timChase98/SpeedOfLightContoller/hw/SpeedOfLightController.png

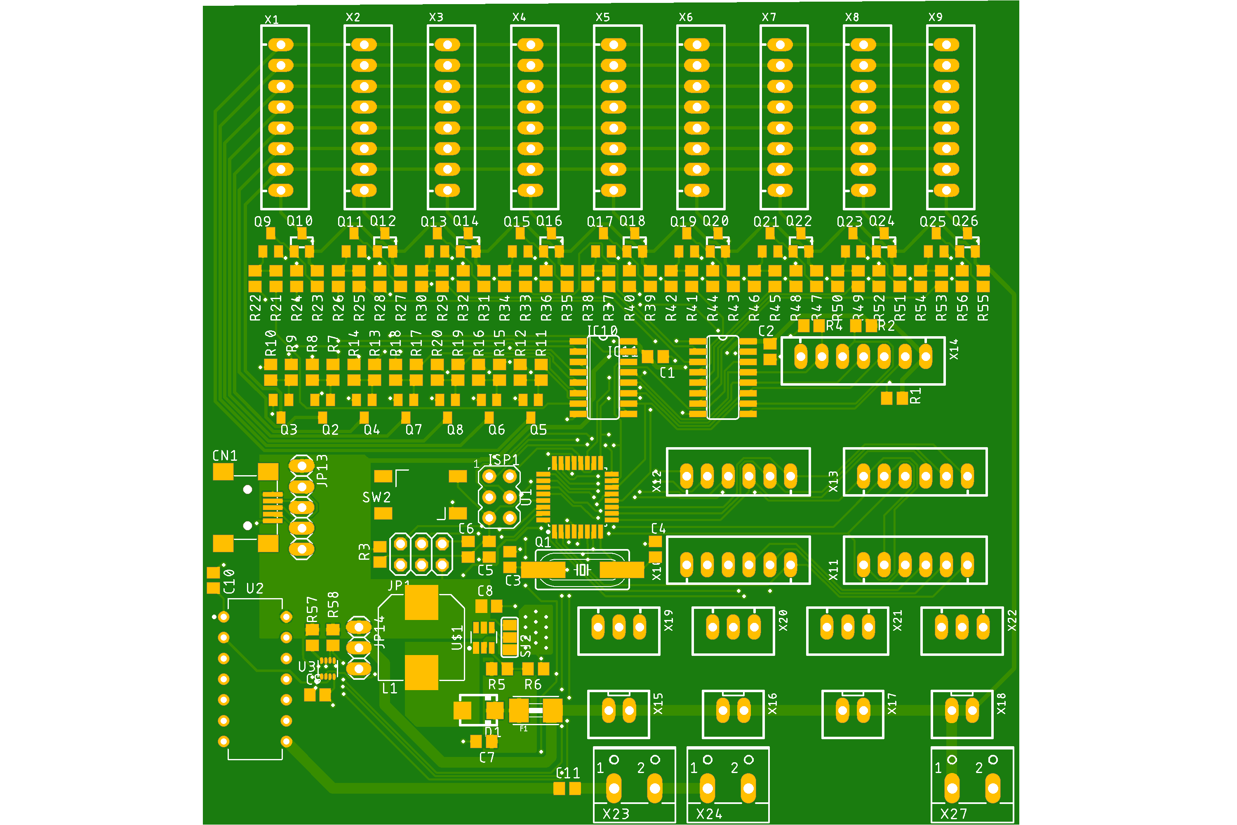
hw/SpeedOfLightController.png
