timChase98/SpeedOfLightContoller/hw/SpeedOfLightController.pdf

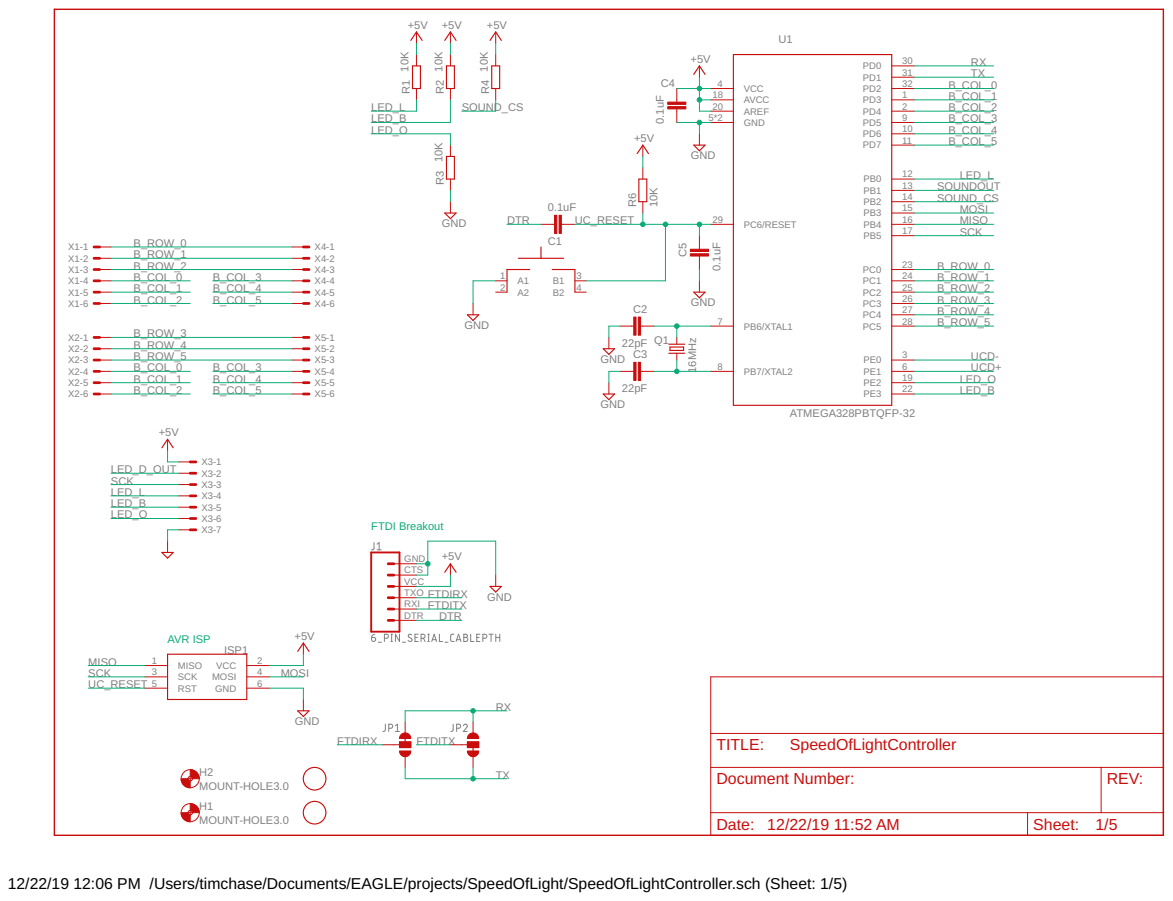
[picture p2: page 1]

Document Number: | REV:

Date: 12/22/19 11:52 AM | Sheet: 1/5

12/22/19 12:06 PM /Users/timchase/Documents/EAGLE/projects/SpeedOfLight/SpeedOfLightController.sch (Sheet: 1/5)

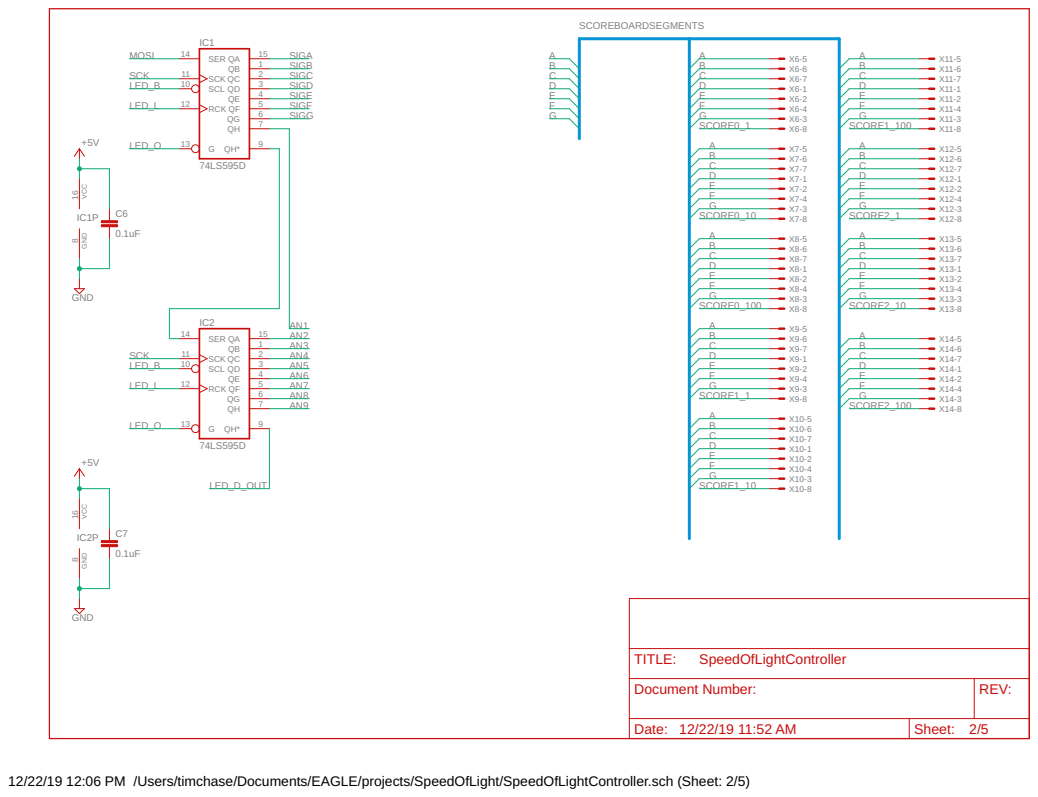
[picture p3: page 2]

Document Number: | REV:

Date: 12/22/19 11:52 AM | Sheet: 2/5

12/22/19 12:06 PM /Users/timchase/Documents/EAGLE/projects/SpeedOfLight/SpeedOfLightController.sch (Sheet: 2/5)

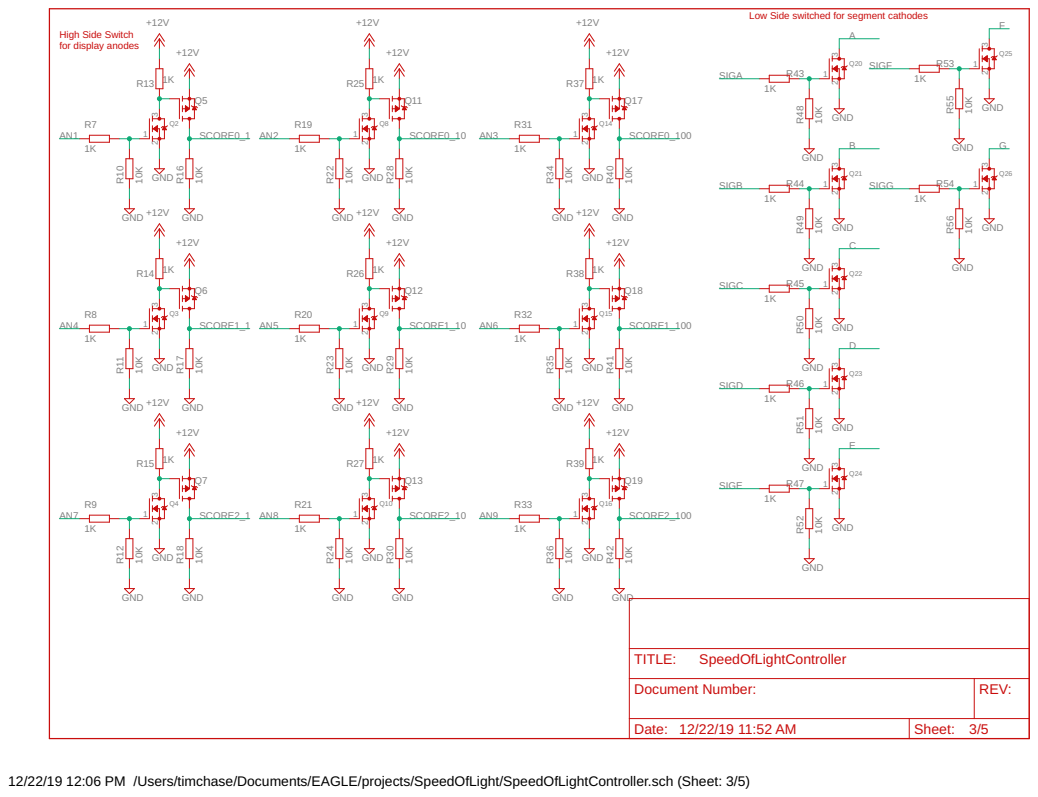
[picture p4: page 3]

Document Number: | REV:

Date: 12/22/19 11:52 AM | Sheet: 3/5

12/22/19 12:06 PM /Users/timchase/Documents/EAGLE/projects/SpeedOfLight/SpeedOfLightController.sch (Sheet: 3/5)

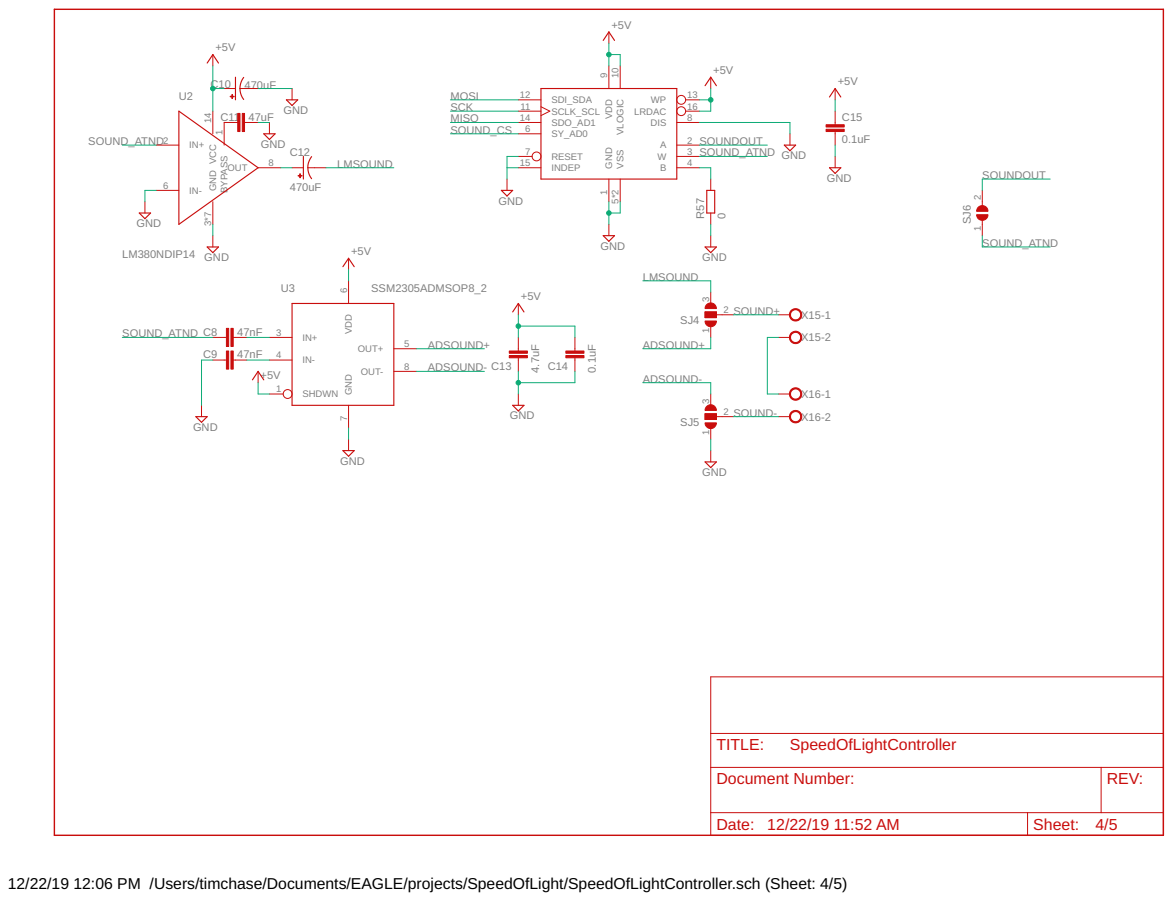
[picture p5: page 4]

Document Number: | REV:

Date: 12/22/19 11:52 AM | Sheet: 4/5

12/22/19 12:06 PM /Users/timchase/Documents/EAGLE/projects/SpeedOfLight/SpeedOfLightController.sch (Sheet: 4/5)

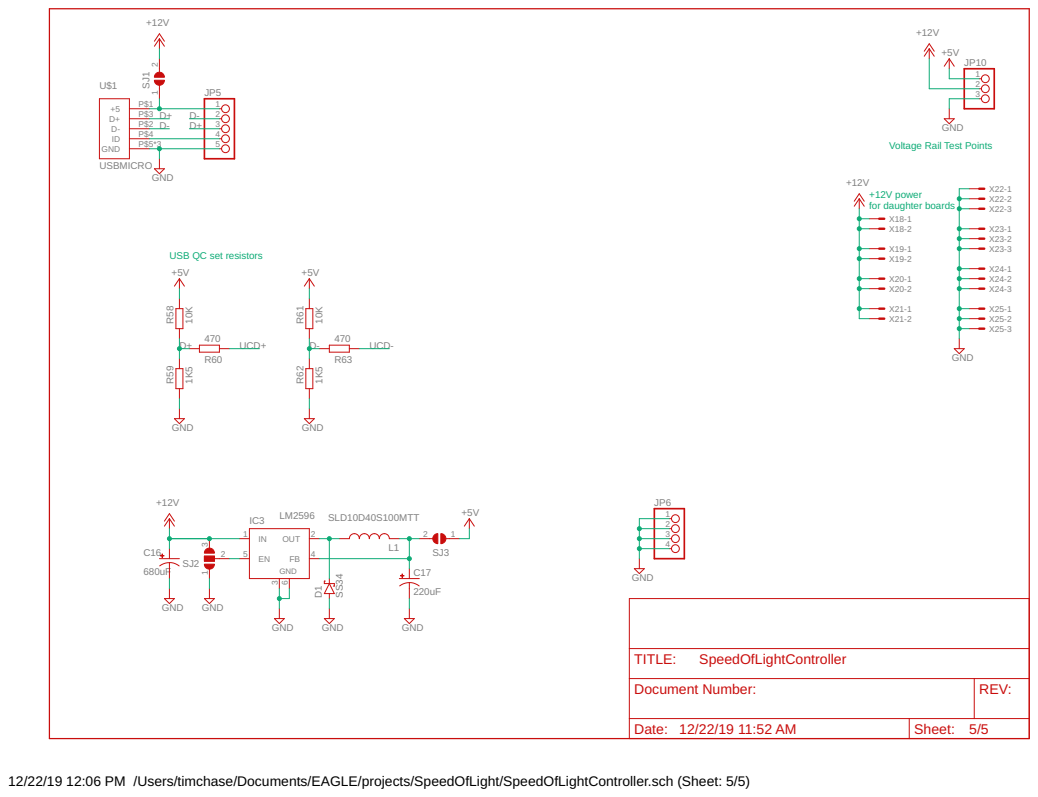
[picture p6: page 5]

Voltage Rail Test Points +12V power

for daughter boards USB QC set resistors

Document Number: | REV:

Date: 12/22/19 11:52 AM | Sheet: 5/5

12/22/19 12:06 PM /Users/timchase/Documents/EAGLE/projects/SpeedOfLight/SpeedOfLightController.sch (Sheet: 5/5)
