timChase98/SpeedOfLightContoller/hw/ButtonBreakout.pdf

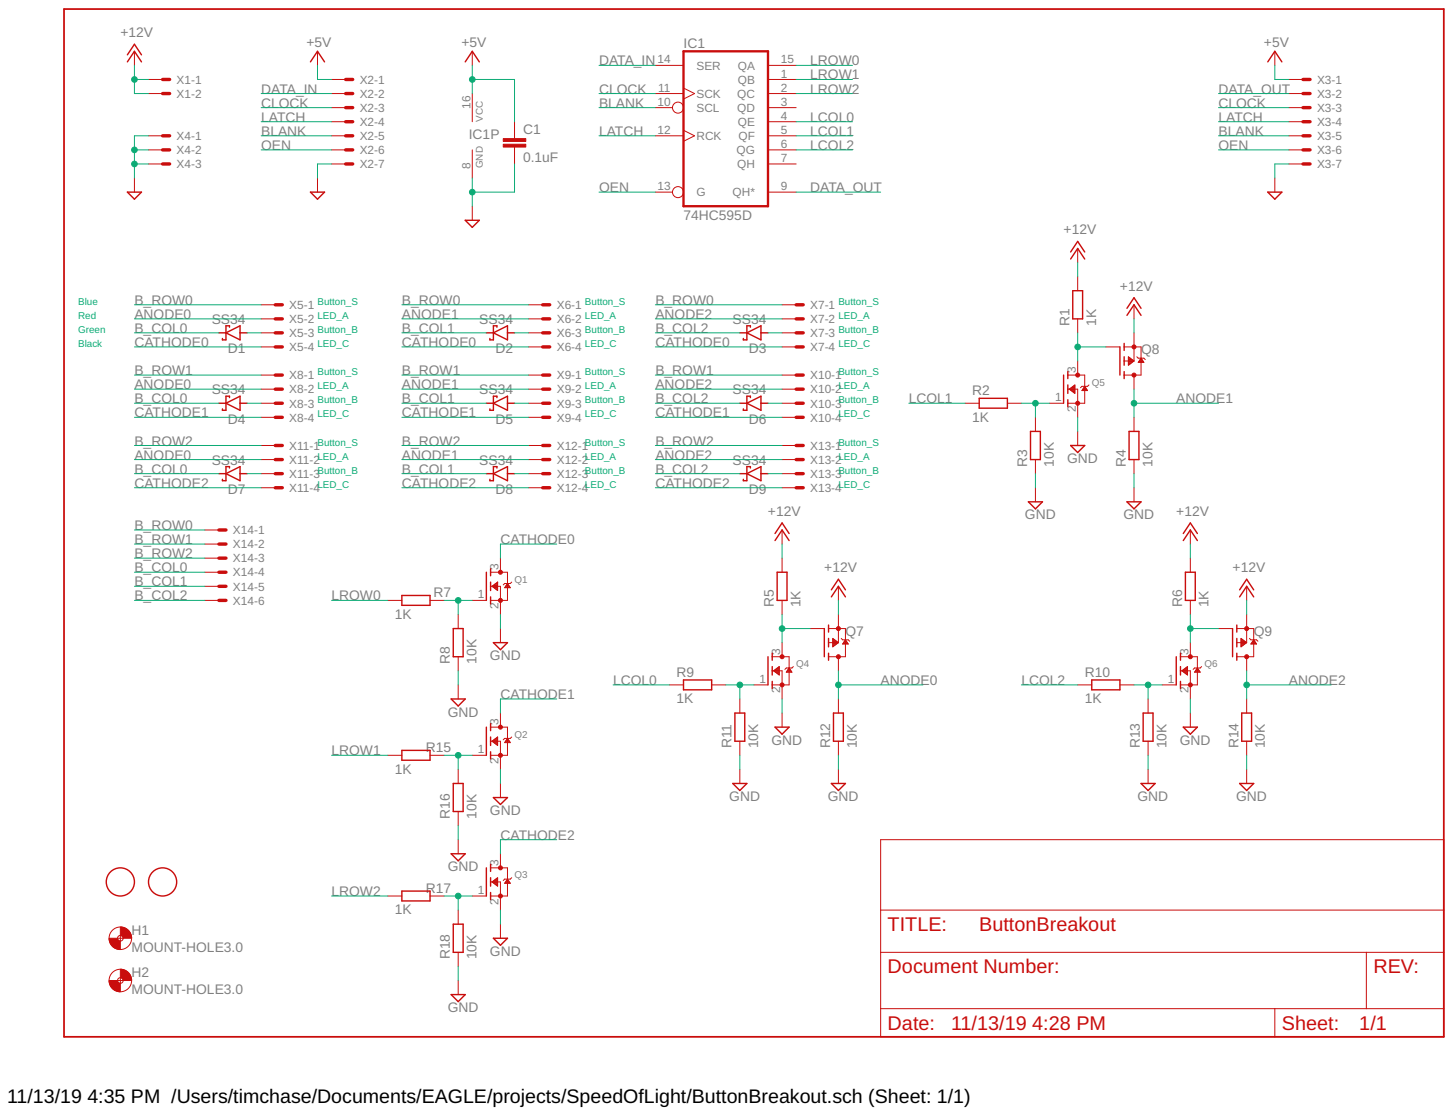
[picture p7: page 1]

Button_B Red Black Blue Green

Document Number: | REV:

Date: 11/13/19 4:28 PM | Sheet: 1/1

11/13/19 4:35 PM /Users/timchase/Documents/EAGLE/projects/SpeedOfLight/ButtonBreakout.sch (Sheet: 1/1)
