timChase98/SpeedOfLightContoller/ButtonBreakout.brd

## EAGLE design hw/ButtonBreakout.brd (2019-11-13, last stored version)

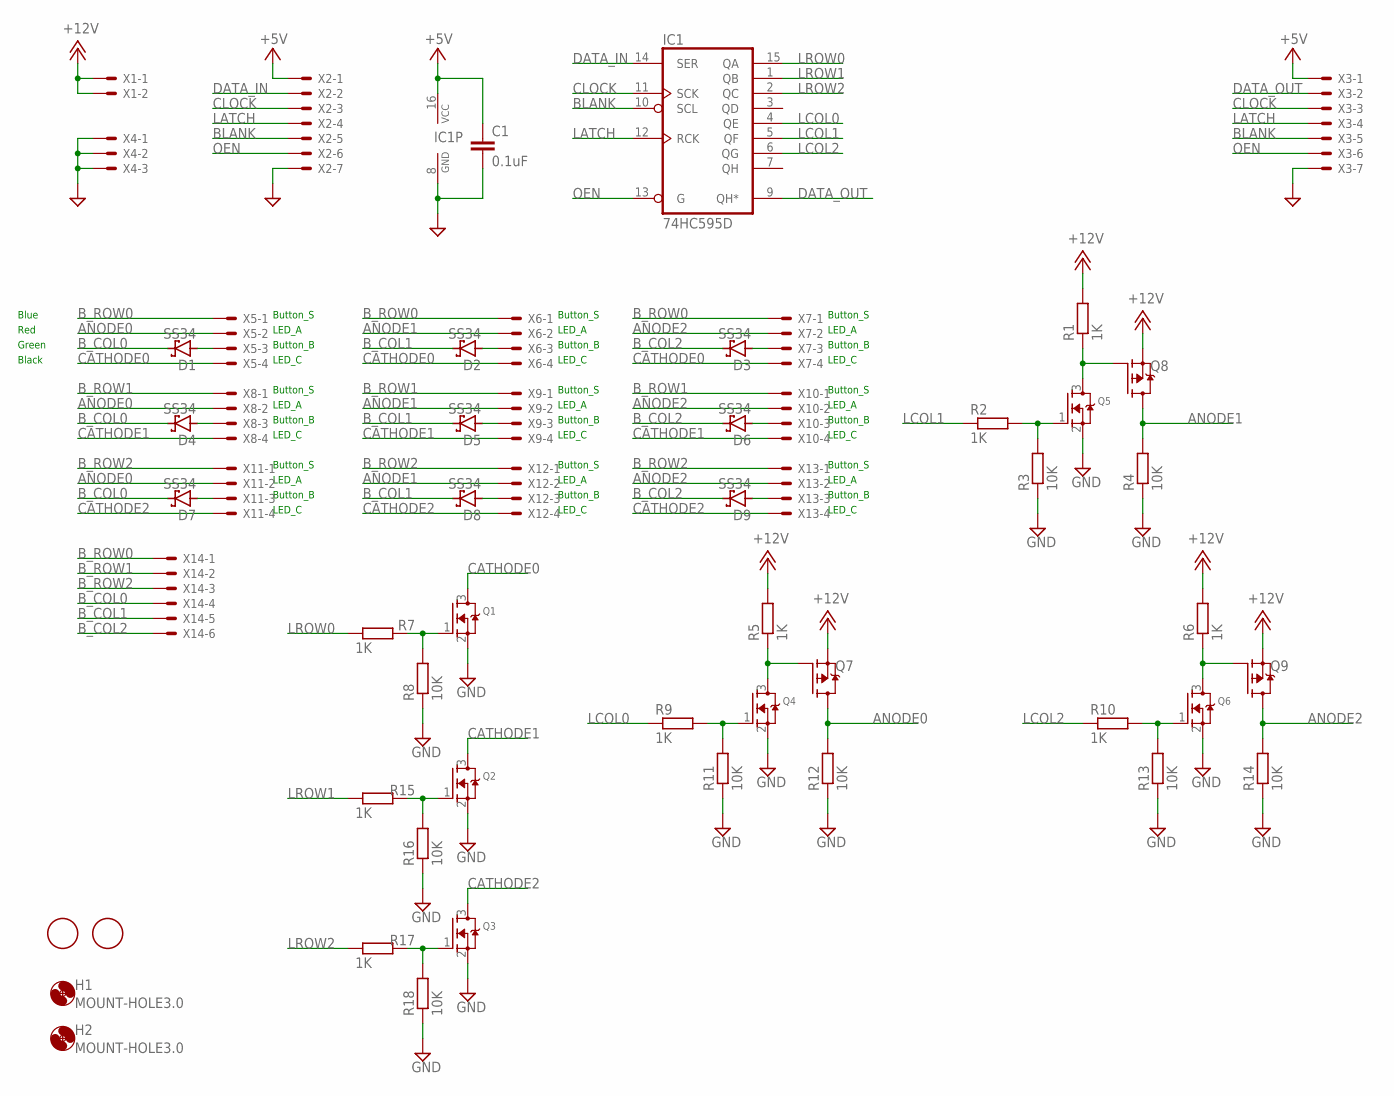
[picture p8: schematic ButtonBreakout.sch]

Parts:
C1: 0.1uF; C0805
D1, D2, D3, D4, D5, D6, D7, D8, D9: SS34; SMA
F1, F2: FIDUCIAL; FIDUCIAL_1MM
H1, H2: MOUNT-HOLE3.0; 3,0
IC1: 74HC595D; SO16
Q1, Q2, Q3, Q4, Q5, Q6: AO3414SOT23; SOT95P240X110-3N
Q7, Q8, Q9: AO3415; SOT95P240X110-3N
R1, R2, R5, R6, R7, R9, R10, R15, R17: 1K; R0805
R3, R4, R8, R11, R12, R13, R14, R16, R18: 10K; R0805
X1: JST-XH-02-PIN-LONG-PAD; JST-XH-02-PACKAGE-LONG-PAD
X2, X3: JST-XH-07-PIN-LONG-PAD; JST-XH-07-PACKAGE-LONG-PAD
X4: JST-XH-03-PIN-LONG-PAD; JST-XH-03-PACKAGE-LONG-PAD
X5, X6, X7, X8, X9, X10, X11, X12, X13: JST-XH-04-PIN-LONG-PAD; JST-XH-04-PACKAGE-LONG-PAD
X14: JST-XH-06-PIN-LONG-PAD; JST-XH-06-PACKAGE-LONG-PAD

Connections:
+5V: C1.1, IC1.16 (VCC), X2.1, X3.1
+12V: Q7.2 (S), Q8.2 (S), Q9.2 (S), R1.2, R5.2, R6.2, X1.1, X1.2
ANODE0: Q7.3 (D), R12.2, X5.2, X8.2, X11.2
ANODE1: Q8.3 (D), R4.2, X6.2, X9.2, X12.2
ANODE2: Q9.3 (D), R14.2, X7.2, X10.2, X13.2
BLANK: IC1.10 (SCL), X2.5, X3.5
B_COL0: D1.C, D4.C, D7.C, X14.4
B_COL1: D2.C, D5.C, D8.C, X14.5
B_COL2: D3.C, D6.C, D9.C, X14.6
B_ROW0: X5.1, X6.1, X7.1, X14.1
B_ROW1: X8.1, X9.1, X10.1, X14.2
B_ROW2: X11.1, X12.1, X13.1, X14.3
CATHODE0: Q1.3 (D), X5.4, X6.4, X7.4
CATHODE1: Q2.3 (D), X8.4, X9.4, X10.4
CATHODE2: Q3.3 (D), X11.4, X12.4, X13.4
CLOCK: IC1.11 (SCK), X2.3, X3.3
DATA_IN: IC1.14 (SER), X2.2
DATA_OUT: IC1.9 (QH*), X3.2
GND: C1.2, IC1.8 (GND), Q1.2 (S), Q2.2 (S), Q3.2 (S), Q4.2 (S), Q5.2 (S), Q6.2 (S), R3.1, R4.1, R8.1, R11.1, R12.1, R13.1, R14.1, R16.1, R18.1, X2.7, X3.7, X4.1, X4.2, X4.3
LATCH: IC1.12 (RCK), X2.4, X3.4
LCOL0: IC1.4 (QE), R9.1
LCOL1: IC1.5 (QF), R2.1
LCOL2: IC1.6 (QG), R10.1
LROW0: IC1.15 (QA), R7.1
LROW1: IC1.1 (QB), R15.1
LROW2: IC1.2 (QC), R17.1
unnamed: Q2.1 (G), R15.2, R16.2
unnamed: Q3.1 (G), R17.2, R18.2
unnamed: Q5.3 (D), Q8.1 (G), R1.1
unnamed: Q5.1 (G), R2.2, R3.2
unnamed: Q1.1 (G), R7.2, R8.2
unnamed: Q4.3 (D), Q7.1 (G), R5.1
unnamed: D1.A, X5.3
unnamed: D2.A, X6.3
unnamed: D3.A, X7.3
unnamed: D4.A, X8.3
unnamed: D5.A, X9.3
unnamed: D6.A, X10.3
unnamed: D7.A, X11.3
unnamed: D8.A, X12.3
unnamed: D9.A, X13.3
unnamed: Q4.1 (G), R9.2, R11.2
unnamed: Q6.3 (D), Q9.1 (G), R6.1
unnamed: Q6.1 (G), R10.2, R13.2
OEN: IC1.13 (G), X2.6, X3.6

Notes on the sheet:
LED_A
LED_C
Button_S
Button_B
Red
Black
Blue
Green

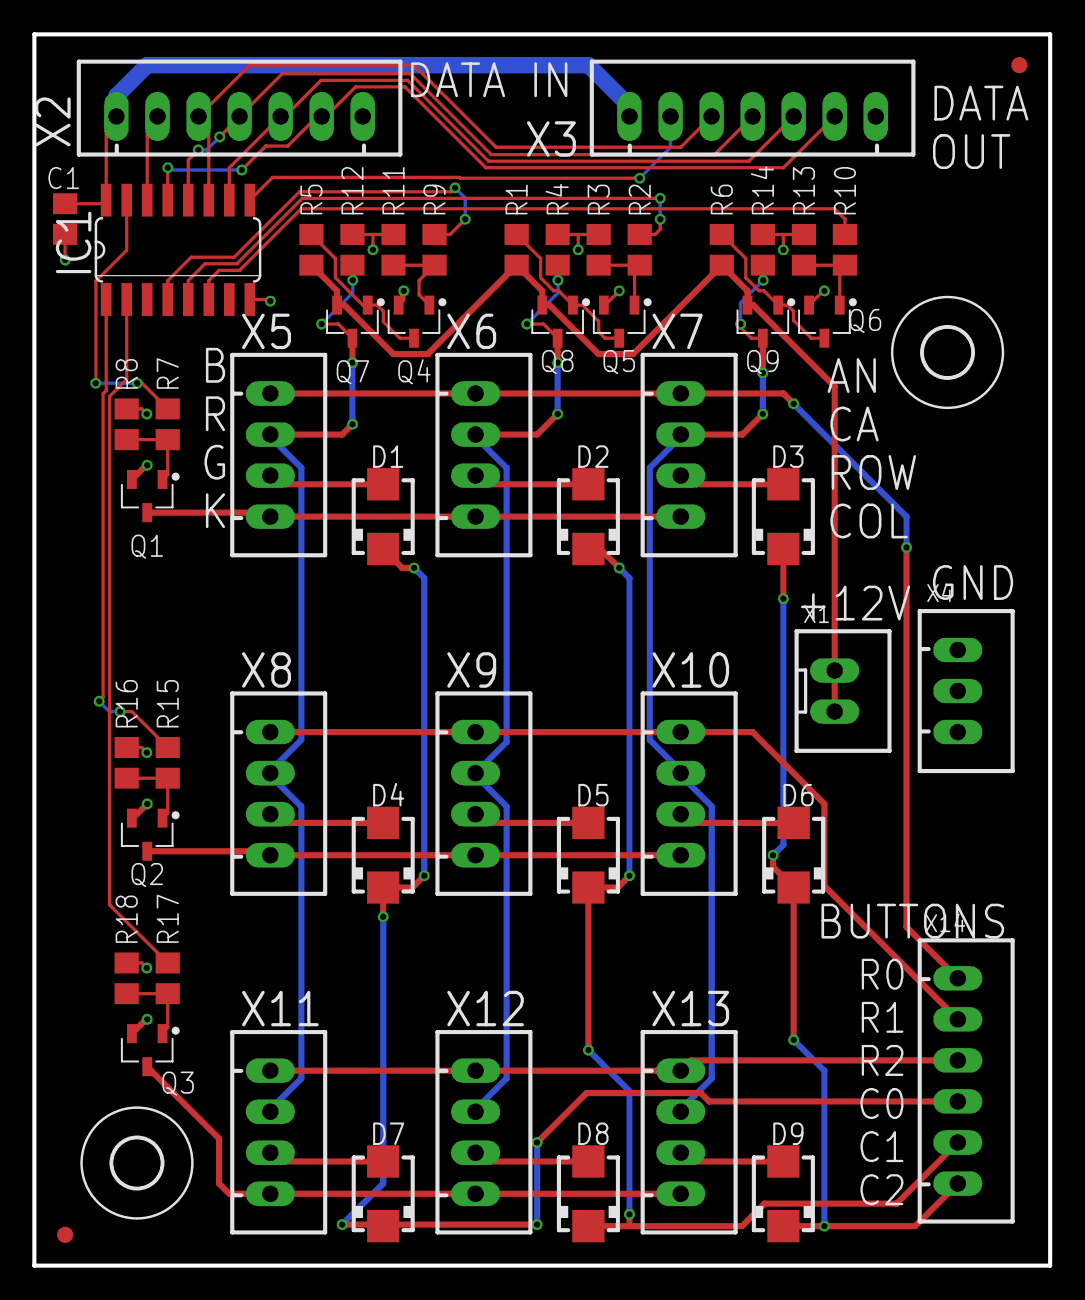
[picture p9: board ButtonBreakout.brd from above]

Board: 2 copper layers, 62.9 x 76.2 mm, 56 parts (0 on the bottom side), 45 nets.
