timChase98/SpeedOfLightContoller/SpeedOfLightController.brd

## EAGLE design hw/SpeedOfLightController.brd (2019-11-13, last stored version)

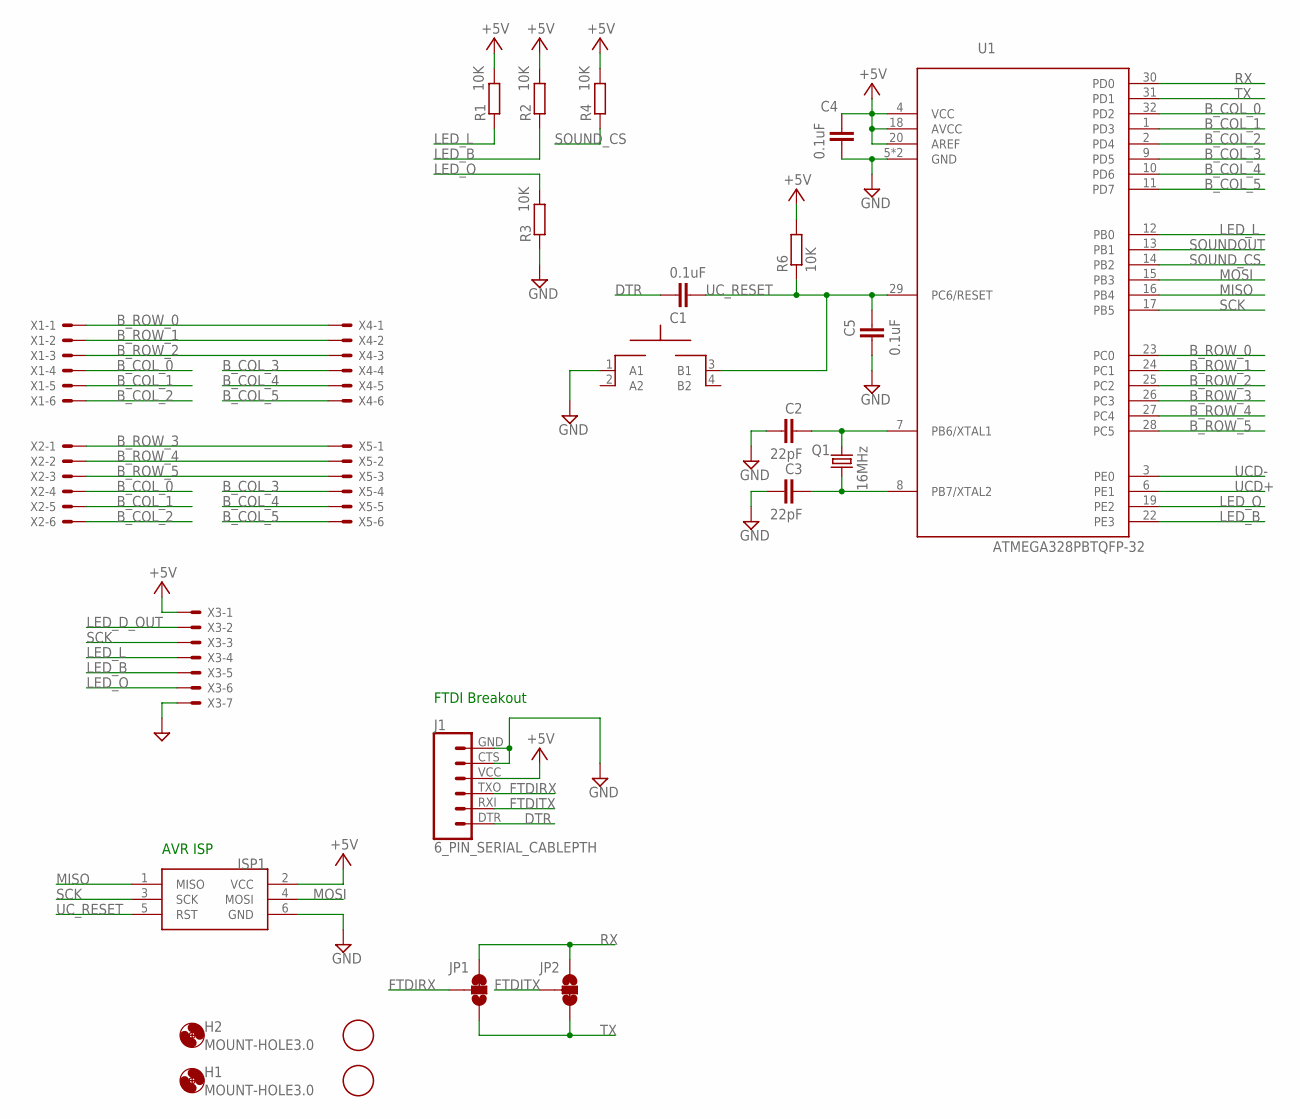
[picture p10: schematic SpeedOfLightController.sch, sheet 1]

Parts:
C1, C4, C5: 0.1uF; C0805
C2, C3: 22pF; C0805
F1, F2: FIDUCIAL; FIDUCIAL_1MM
H1, H2: MOUNT-HOLE3.0; 3,0
ISP1: AVRISP-6; AVRISP
J1: 6_PIN_SERIAL_CABLEPTH; FTDI_BASIC
JP1, JP2: JUMPER-SMT_3_1-NC_TRACE_SILK; SMT-JUMPER_3_1-NC_TRACE_SILK
Q1: 16MHz; HC49UP
R1, R2, R3, R4, R6: 10K; R0805
RESET: MOMENTARYBUTTON; SPST_NO_SMD
U1: ATMEGA328PBTQFP-32; QFP80P900X900X120-32N
X1, X2, X4, X5: JST-XH-06-PIN-LONG-PAD; JST-XH-06-PACKAGE-LONG-PAD
X3: JST-XH-07-PIN-LONG-PAD; JST-XH-07-PACKAGE-LONG-PAD

Connections:
+5V: C4.2, ISP1.2 (VCC), J1.VCC (4), R1.2, R2.2, R4.2, R6.2, U1.4 (VCC), U1.18 (AVCC), U1.20 (AREF), X3.1; also elsewhere on the board
B_COL_0: U1.32 (PD2), X1.4, X2.4
B_COL_1: U1.1 (PD3), X1.5, X2.5
B_COL_2: U1.2 (PD4), X1.6, X2.6
B_COL_3: U1.9 (PD5), X4.4, X5.4
B_COL_4: U1.10 (PD6), X4.5, X5.5
B_COL_5: U1.11 (PD7), X4.6, X5.6
B_ROW_0: U1.23 (PC0), X1.1, X4.1
B_ROW_1: U1.24 (PC1), X1.2, X4.2
B_ROW_2: U1.25 (PC2), X1.3, X4.3
B_ROW_3: U1.26 (PC3), X2.1, X5.1
B_ROW_4: U1.27 (PC4), X2.2, X5.2
B_ROW_5: U1.28 (PC5), X2.3, X5.3
DTR: C1.2, J1.DTR (1)
FTDIRX: J1.TXO (3), JP1.2
FTDITX: J1.RXI (2), JP2.2
GND: C2.1, C3.1, C4.1, C5.1, ISP1.6 (GND), J1.CTS (5), J1.GND (6), R3.1, RESET.1 (A1), U1.5 (GND), U1.21 (GND), X3.7; also elsewhere on the board
LED_B: R2.1, U1.22 (PE3), X3.5; also elsewhere on the board
LED_D_OUT: X3.2; also elsewhere on the board
LED_L: R1.1, U1.12 (PB0), X3.4; also elsewhere on the board
LED_O: R3.2, U1.19 (PE2), X3.6; also elsewhere on the board
MISO: ISP1.1 (MISO), U1.16 (PB4); also elsewhere on the board
MOSI: ISP1.4 (MOSI), U1.15 (PB3); also elsewhere on the board
unnamed: C2.2, Q1.1, U1.7 (PB6/XTAL1)
unnamed: C3.2, Q1.2, U1.8 (PB7/XTAL2)
RX: JP1.3, JP2.1, U1.30 (PD0)
SCK: ISP1.3 (SCK), U1.17 (PB5), X3.3; also elsewhere on the board
SOUNDOUT: U1.13 (PB1); also elsewhere on the board
SOUND_CS: R4.1, U1.14 (PB2); also elsewhere on the board
TX: JP1.1, JP2.3, U1.31 (PD1)
UCD+: U1.6 (PE1); also elsewhere on the board
UCD-: U1.3 (PE0); also elsewhere on the board
UC_RESET: C1.1, C5.2, ISP1.5 (RST), R6.1, RESET.3 (B1), U1.29 (PC6/RESET)

Notes on the sheet:
AVR ISP
FTDI Breakout

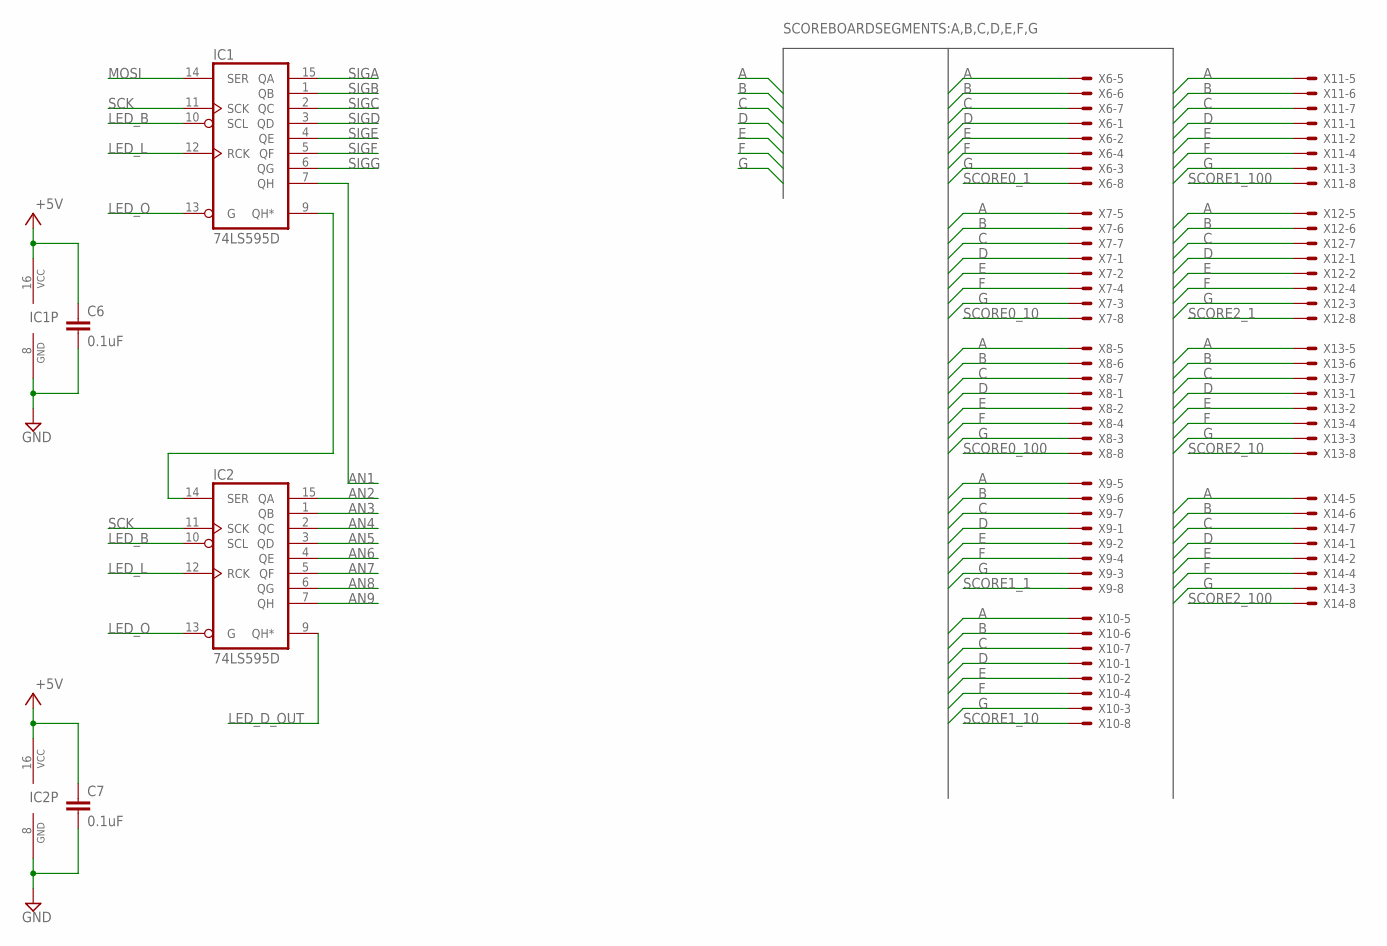
[picture p11: schematic SpeedOfLightController.sch, sheet 2, ScoreBoard]

Parts:
C6, C7: 0.1uF; C0805
IC1, IC2: 74LS595D; SO16
X6, X7, X8, X9, X10, X11, X12, X13, X14: JST-XH-08-PIN-LONG-PAD; JST-XH-08-PACKAGE-LONG-PAD

Connections:
+5V: C6.1, C7.1, IC1.16 (VCC), IC2.16 (VCC); also elsewhere on the board
A: X6.5, X7.5, X8.5, X9.5, X10.5, X11.5, X12.5, X13.5, X14.5; also elsewhere on the board
AN1: IC1.7 (QH); also elsewhere on the board
AN2: IC2.15 (QA); also elsewhere on the board
AN3: IC2.1 (QB); also elsewhere on the board
AN4: IC2.2 (QC); also elsewhere on the board
AN5: IC2.3 (QD); also elsewhere on the board
AN6: IC2.4 (QE); also elsewhere on the board
AN7: IC2.5 (QF); also elsewhere on the board
AN8: IC2.6 (QG); also elsewhere on the board
AN9: IC2.7 (QH); also elsewhere on the board
B: X6.6, X7.6, X8.6, X9.6, X10.6, X11.6, X12.6, X13.6, X14.6; also elsewhere on the board
C: X6.7, X7.7, X8.7, X9.7, X10.7, X11.7, X12.7, X13.7, X14.7; also elsewhere on the board
D: X6.1, X7.1, X8.1, X9.1, X10.1, X11.1, X12.1, X13.1, X14.1; also elsewhere on the board
E: X6.2, X7.2, X8.2, X9.2, X10.2, X11.2, X12.2, X13.2, X14.2; also elsewhere on the board
F: X6.4, X7.4, X8.4, X9.4, X10.4, X11.4, X12.4, X13.4, X14.4; also elsewhere on the board
G: X6.3, X7.3, X8.3, X9.3, X10.3, X11.3, X12.3, X13.3, X14.3; also elsewhere on the board
GND: C6.2, C7.2, IC1.8 (GND), IC2.8 (GND); also elsewhere on the board
LED_B: IC1.10 (SCL), IC2.10 (SCL); also elsewhere on the board
LED_D_OUT: IC2.9 (QH*); also elsewhere on the board
LED_L: IC1.12 (RCK), IC2.12 (RCK); also elsewhere on the board
LED_O: IC1.13 (G), IC2.13 (G); also elsewhere on the board
MOSI: IC1.14 (SER); also elsewhere on the board
unnamed: IC1.9 (QH*), IC2.14 (SER)
SCK: IC1.11 (SCK), IC2.11 (SCK); also elsewhere on the board
SCORE0_1: X6.8; also elsewhere on the board
SCORE0_10: X7.8; also elsewhere on the board
SCORE0_100: X8.8; also elsewhere on the board
SCORE1_1: X9.8; also elsewhere on the board
SCORE1_10: X10.8; also elsewhere on the board
SCORE1_100: X11.8; also elsewhere on the board
SCORE2_1: X12.8; also elsewhere on the board
SCORE2_10: X13.8; also elsewhere on the board
SCORE2_100: X14.8; also elsewhere on the board
SIGA: IC1.15 (QA); also elsewhere on the board
SIGB: IC1.1 (QB); also elsewhere on the board
SIGC: IC1.2 (QC); also elsewhere on the board
SIGD: IC1.3 (QD); also elsewhere on the board
SIGE: IC1.4 (QE); also elsewhere on the board
SIGF: IC1.5 (QF); also elsewhere on the board
SIGG: IC1.6 (QG); also elsewhere on the board

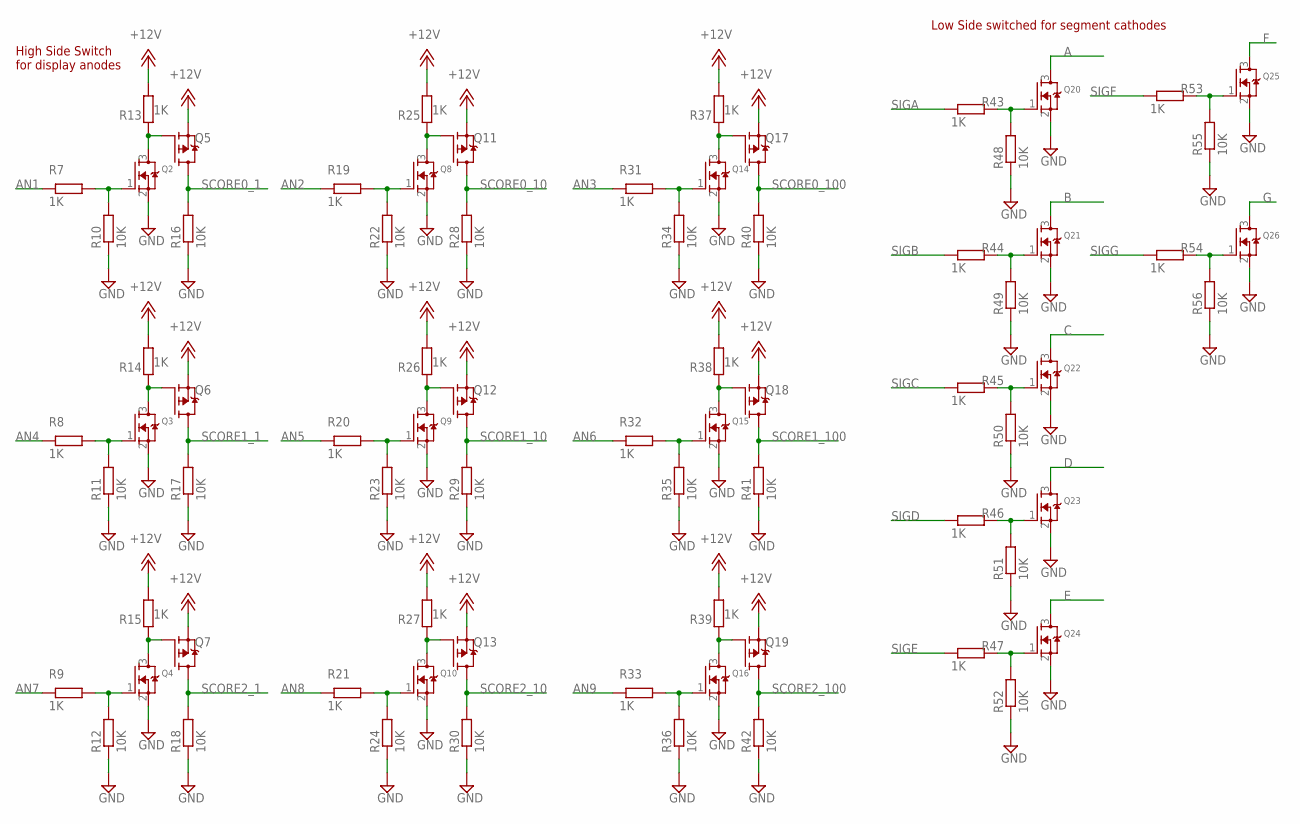
[picture p12: schematic SpeedOfLightController.sch, sheet 3, Scoreboard switches]

Parts:
Q2, Q3, Q4, Q8, Q9, Q10, Q14, Q15, Q16, Q20, Q21, Q22, Q23, Q24, Q25, Q26: AO3414SOT23; SOT95P240X110-3N
Q5, Q6, Q7, Q11, Q12, Q13, Q17, Q18, Q19: AO3415; SOT95P240X110-3N
R7, R8, R9, R13, R14, R15, R19, R20, R21, R25, R26, R27, R31, R32, R33, R37, R38, R39, R43, R44, R45, R46, R47, R53, R54: 1K; R0805
R10, R11, R12, R16, R17, R18, R22, R23, R24, R28, R29, R30, R34, R35, R36, R40, R41, R42, R48, R49, R50, R51, R52, R55, R56: 10K; R0805

Connections:
+12V: Q5.2 (S), Q6.2 (S), Q7.2 (S), Q11.2 (S), Q12.2 (S), Q13.2 (S), Q17.2 (S), Q18.2 (S), Q19.2 (S), R13.2, R14.2, R15.2, R25.2, R26.2, R27.2, R37.2, R38.2, R39.2; also elsewhere on the board
A: Q20.3 (D); also elsewhere on the board
AN1: R7.1; also elsewhere on the board
AN2: R19.1; also elsewhere on the board
AN3: R31.1; also elsewhere on the board
AN4: R8.1; also elsewhere on the board
AN5: R20.1; also elsewhere on the board
AN6: R32.1; also elsewhere on the board
AN7: R9.1; also elsewhere on the board
AN8: R21.1; also elsewhere on the board
AN9: R33.1; also elsewhere on the board
B: Q21.3 (D); also elsewhere on the board
C: Q22.3 (D); also elsewhere on the board
D: Q23.3 (D); also elsewhere on the board
E: Q24.3 (D); also elsewhere on the board
F: Q25.3 (D); also elsewhere on the board
G: Q26.3 (D); also elsewhere on the board
GND: Q2.2 (S), Q3.2 (S), Q4.2 (S), Q8.2 (S), Q9.2 (S), Q10.2 (S), Q14.2 (S), Q15.2 (S), Q16.2 (S), Q20.2 (S), Q21.2 (S), Q22.2 (S), Q23.2 (S), Q24.2 (S), Q25.2 (S), Q26.2 (S), R10.1, R11.1, R12.1, R16.1, R17.1, R18.1, R22.1, R23.1, R24.1, R28.1, R29.1, R30.1, R34.1, R35.1, R36.1, R40.1, R41.1, R42.1, R48.1, R49.1, R50.1, R51.1, R52.1, R55.1, R56.1; also elsewhere on the board
unnamed: Q21.1 (G), R44.2, R49.2
unnamed: Q22.1 (G), R45.2, R50.2
unnamed: Q23.1 (G), R46.2, R51.2
unnamed: Q24.1 (G), R47.2, R52.2
unnamed: Q20.1 (G), R43.2, R48.2
unnamed: Q25.1 (G), R53.2, R55.2
unnamed: Q26.1 (G), R54.2, R56.2
unnamed: Q2.1 (G), R7.2, R10.2
unnamed: Q8.1 (G), R19.2, R22.2
unnamed: Q14.1 (G), R31.2, R34.2
unnamed: Q3.1 (G), R8.2, R11.2
unnamed: Q9.1 (G), R20.2, R23.2
unnamed: Q15.1 (G), R32.2, R35.2
unnamed: Q4.1 (G), R9.2, R12.2
unnamed: Q10.1 (G), R21.2, R24.2
unnamed: Q16.1 (G), R33.2, R36.2
unnamed: Q16.3 (D), Q19.1 (G), R39.1
unnamed: Q10.3 (D), Q13.1 (G), R27.1
unnamed: Q4.3 (D), Q7.1 (G), R15.1
unnamed: Q3.3 (D), Q6.1 (G), R14.1
unnamed: Q9.3 (D), Q12.1 (G), R26.1
unnamed: Q15.3 (D), Q18.1 (G), R38.1
unnamed: Q14.3 (D), Q17.1 (G), R37.1
unnamed: Q8.3 (D), Q11.1 (G), R25.1
unnamed: Q2.3 (D), Q5.1 (G), R13.1
SCORE0_1: Q5.3 (D), R16.2; also elsewhere on the board
SCORE0_10: Q11.3 (D), R28.2; also elsewhere on the board
SCORE0_100: Q17.3 (D), R40.2; also elsewhere on the board
SCORE1_1: Q6.3 (D), R17.2; also elsewhere on the board
SCORE1_10: Q12.3 (D), R29.2; also elsewhere on the board
SCORE1_100: Q18.3 (D), R41.2; also elsewhere on the board
SCORE2_1: Q7.3 (D), R18.2; also elsewhere on the board
SCORE2_10: Q13.3 (D), R30.2; also elsewhere on the board
SCORE2_100: Q19.3 (D), R42.2; also elsewhere on the board
SIGA: R43.1; also elsewhere on the board
SIGB: R44.1; also elsewhere on the board
SIGC: R45.1; also elsewhere on the board
SIGD: R46.1; also elsewhere on the board
SIGE: R47.1; also elsewhere on the board
SIGF: R53.1; also elsewhere on the board
SIGG: R54.1; also elsewhere on the board

Notes on the sheet:
High Side Switch for display anodes
Low Side switched for segment cathodes

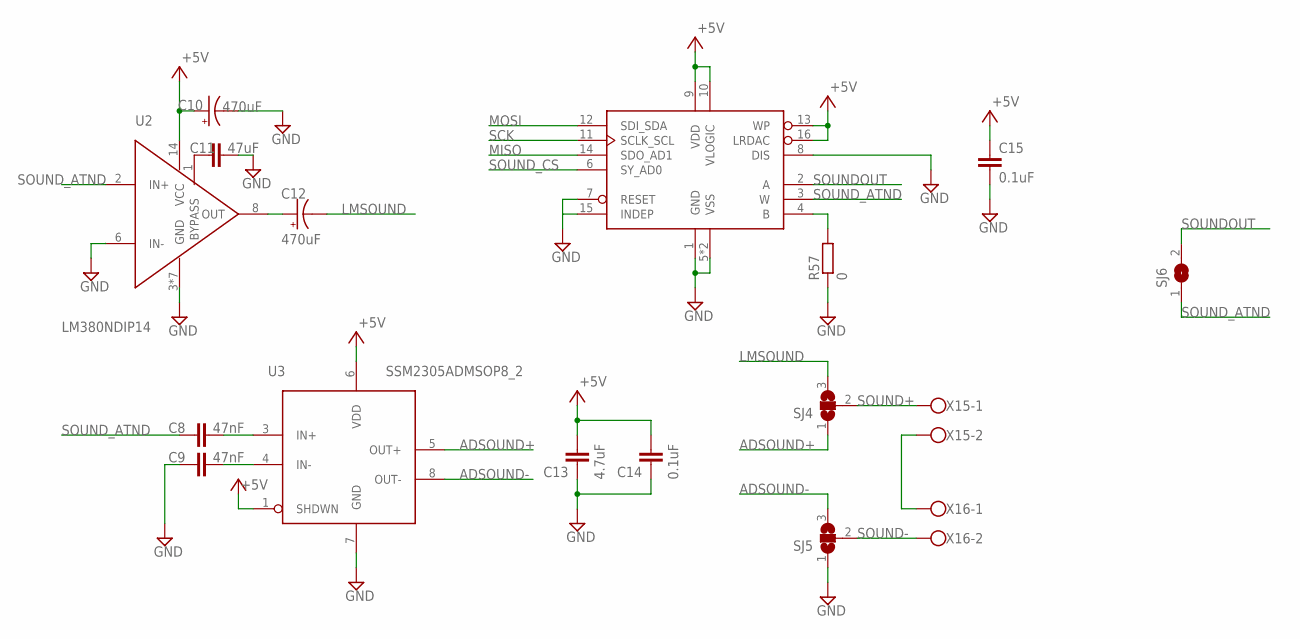
[picture p13: schematic SpeedOfLightController.sch, sheet 4, Sound]

Parts:
C8, C9: 47nF; C0805
C10, C12: 470uF; 140CLH-0810
C11: 47uF; C0805
C13: 4.7uF; C0805
C14, C15: 0.1uF; C0805
R57: 0; R0805W
SJ4, SJ5: SJ2W; SJ_2
SJ6: SJ
U2: LM380NDIP14; DIP762W53P254L1969H508Q14B
U3: SSM2305ADMSOP8_2; SOP65P490X95-8N
U4: AD5141ADLFCSP3; QFN50P300X300X80-17T160N
X15, X16: 1X02_5MM_SCREW; W237-102

Connections:
+5V: C10.+, C13.2, C14.2, C15.1, U2.14 (VCC), U3.1 (SHDWN), U3.6 (VDD), U4.9 (VDD), U4.10 (VLOGIC), U4.13 (WP), U4.16 (LRDAC); also elsewhere on the board
ADSOUND+: SJ4.1, U3.5 (OUT+)
ADSOUND-: SJ5.3, U3.8 (OUT-)
GND: C9.1, C10.-, C11.2, C13.1, C14.1, C15.2, R57.1, SJ5.1, U2.3 (GND), U2.4 (GND), U2.5 (GND), U2.6 (IN-), U2.7 (GND), U2.10 (GND), U2.11 (GND), U2.12 (GND), U3.7 (GND), U4.1 (GND), U4.5 (VSS), U4.7 (RESET), U4.8 (DIS), U4.15 (INDEP), U4.17 (VSS); also elsewhere on the board
LMSOUND: C12.-, SJ4.3
MISO: U4.14 (SDO_AD1); also elsewhere on the board
MOSI: U4.12 (SDI_SDA); also elsewhere on the board
unnamed: X15.2, X16.1
unnamed: C12.+, U2.8 (OUT)
unnamed: C11.1, U2.1 (BYPASS)
unnamed: C9.2, U3.4 (IN-)
unnamed: C8.2, U3.3 (IN+)
unnamed: R57.2, U4.4 (B)
SCK: U4.11 (SCLK_SCL); also elsewhere on the board
SOUND+: SJ4.2, X15.1
SOUND-: SJ5.2, X16.2
SOUNDOUT: SJ6.2, U4.2 (A); also elsewhere on the board
SOUND_ATND: C8.1, SJ6.1, U2.2 (IN+), U4.3 (W)
SOUND_CS: U4.6 (SY_AD0); also elsewhere on the board

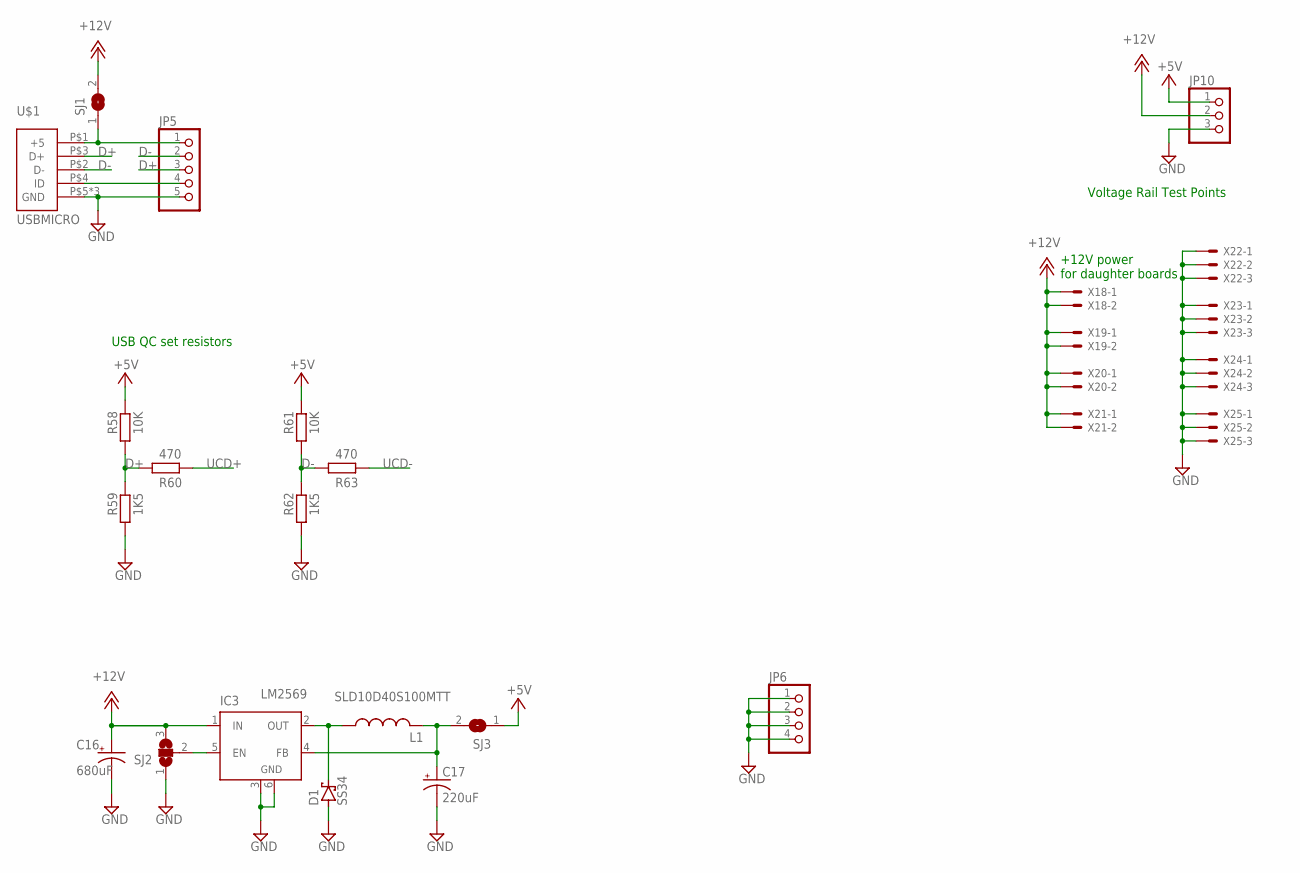
[picture p14: schematic SpeedOfLightController.sch, sheet 5, POWER]

Parts:
C16: 680uF; 140CLH-0810
C17: 220uF; 140CLH-0810
D1: SS34; SMA
IC3: LM2596S; TO263-5
JP5: PINHD-1X5; 1X05
JP6: PINHD-1X4; 1X04
JP10: PINHD-1X3; 1X03
L1: SLD10D40S100MTT; SMD10.5X10.3
R58, R61: 10K; R0805
R59, R62: 1K5; R0805
R60, R63: 470; R0805
SJ1, SJ3: SJ
SJ2: SJ2WW; SJ_2W
U$1: USBMICRO
X18, X19, X20, X21: JST-XH-02-PIN-LONG-PAD; JST-XH-02-PACKAGE-LONG-PAD
X22, X23, X24, X25: JST-XH-03-PIN-LONG-PAD; JST-XH-03-PACKAGE-LONG-PAD

Connections:
+5V: JP10.1, R58.2, R61.1, SJ3.1; also elsewhere on the board
+12V: C16.+, IC3.1 (IN), JP10.2, SJ1.2, SJ2.3, X18.1, X18.2, X19.1, X19.2, X20.1, X20.2, X21.1, X21.2; also elsewhere on the board
D+: JP5.3, R58.1, R59.2, R60.2, U$1.P$3 (D+)
D-: JP5.2, R61.2, R62.1, R63.1, U$1.P$2 (D-)
GND: C16.-, C17.-, D1.A, IC3.3 (GND), IC3.6 (GND), JP5.5, JP6.1, JP6.2, JP6.3, JP6.4, JP10.3, R59.1, R62.2, SJ2.1, U$1.P$5 (GND), U$1.P$6 (GND), U$1.P$8 (GND), X22.1, X22.2, X22.3, X23.1, X23.2, X23.3, X24.1, X24.2, X24.3, X25.1, X25.2, X25.3; also elsewhere on the board
unnamed: JP5.1, SJ1.1, U$1.P$1 (+5)
unnamed: JP5.4, U$1.P$4 (ID)
unnamed: D1.C, IC3.2 (OUT), L1.P$1 (1)
unnamed: IC3.5 (EN), SJ2.2
unnamed: C17.+, IC3.4 (FB), L1.P$2 (2), SJ3.2
UCD+: R60.1; also elsewhere on the board
UCD-: R63.2; also elsewhere on the board

Notes on the sheet:
Voltage Rail Test Points
+12V power for daughter boards
USB QC set resistors
LM2569

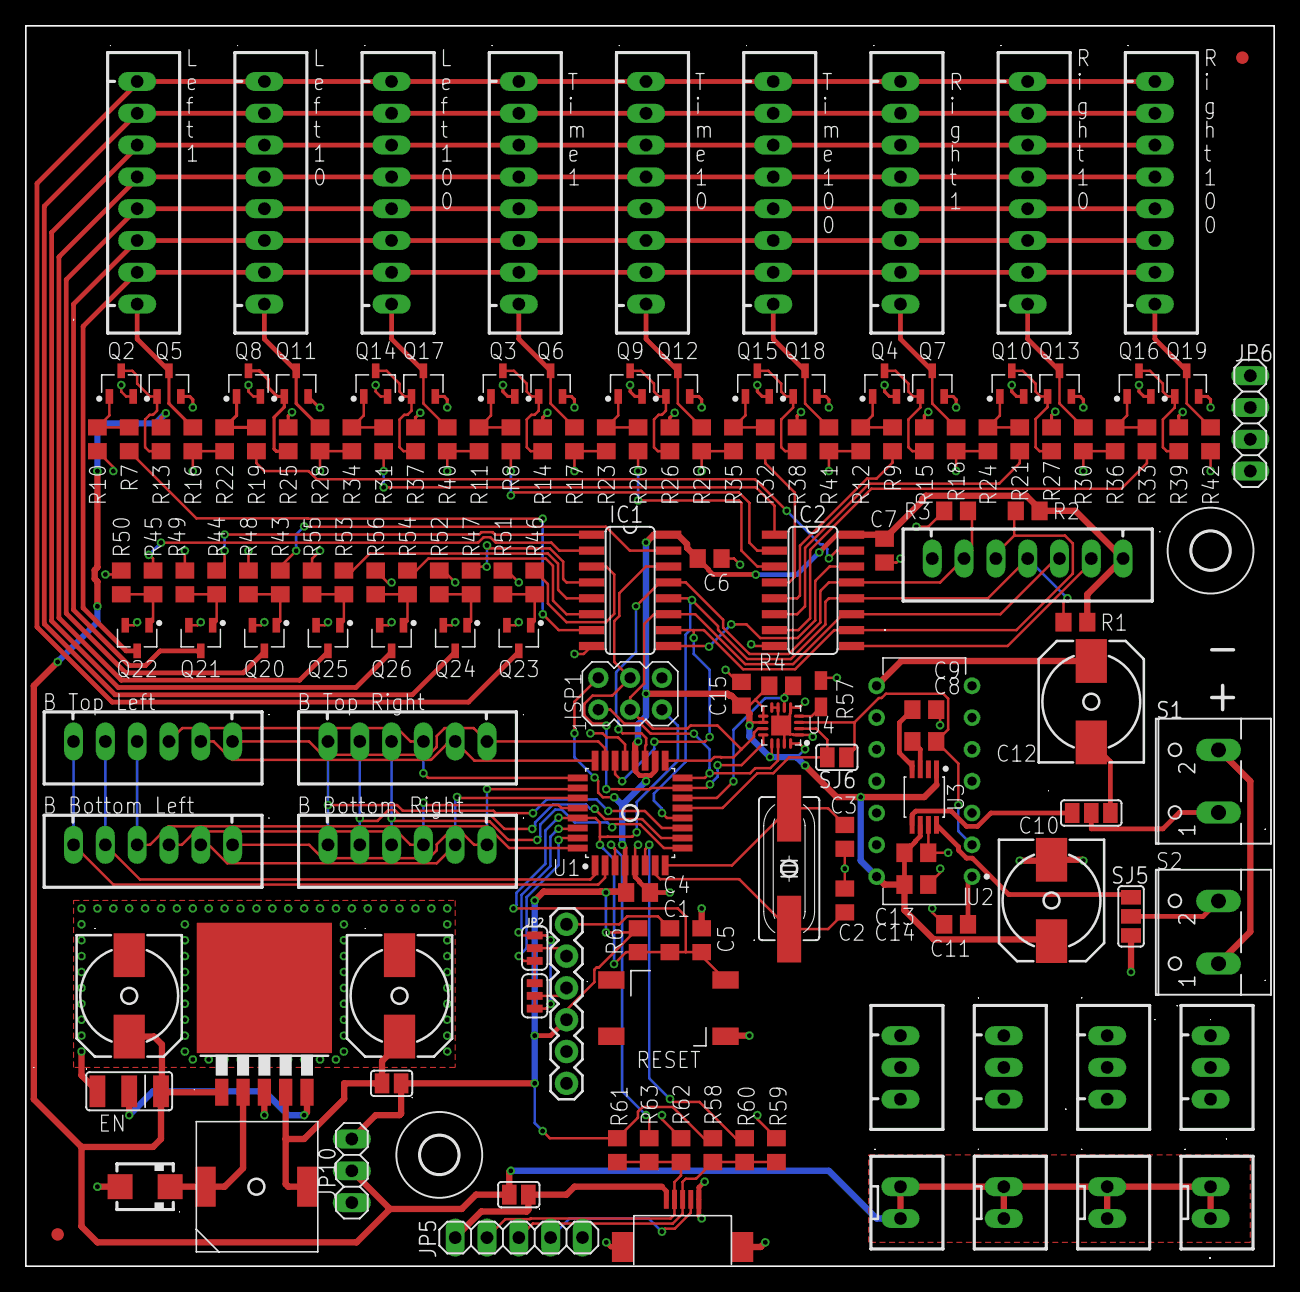
[picture p15: board SpeedOfLightController.brd from above]

Board: 2 copper layers, 99.7 x 99.1 mm, 157 parts (0 on the bottom side), 111 nets.
