timChase98/SpeedOfLightContoller/sw/speedOfLight/buttons.h

/*
* buttons.h
*
* Created: 11/27/2019 9:33:37 AM
*  Author: tchase
*/


#ifndef BUTTONS_H_
#define BUTTONS_H_

#define  LED_L 0 // led latch on B.0
#define  LED_B 3 // led blank on E.3

enum ScoreDisplay {
	LEFT = 0,
	TIMER = 1,
	RIGHT = 2,
	LEFT1 = 0,
	LEFT10 = 1,
	LEFT100 = 2,
	TIMER1 = 3,
	TIMER10 = 4,
	TIMER100 = 5,
	RIGHT1 = 6,
	RIGHT10 = 7,
	RIGHT100 = 8,
	
};


void buttonsInit();
void clearLeds(uint8_t);

void spiSetup();
void tmrSetup();
uint8_t isButtonDown(uint8_t x, uint8_t y);
void setButtonLed(uint8_t x, uint8_t y, uint8_t value);
int getButtonLed(uint8_t x, uint8_t y);
void setScore(uint8_t display, uint16_t value);
void setScoreSegment(uint8_t segment, uint8_t val);


const extern uint8_t sevenSegmentDecode[];


#endif /* BUTTONS_H_ */
