timChase98/SpeedOfLightContoller/sw/speedOfLight/usbQc.c

/*
* ubsQc.c
*
* Created: 11/20/2019 8:50:06 AM
*  Author: tchase
*/

#include "usbQc.h"
#define F_CPU 16000000UL
#include <util/delay.h>

void usbQcInit(){
	_handshake();
	QCset5V();
}

void _handshake(){
	_dm600mV();
	_delay_ms(1500);
	_dm0V();
	_delay_ms(2);
	
}

void QCset5V(){
	_dp600mV();
	_dm0V();
	
}

void QCset9V(){
	_dp3V3();
	_dm600mV();
	
}

void QCset12V(){
	_dp600mV();
	_dm600mV();
}

void _dm0V(){
	QC_PORT &= ~(1 << QC_DM);
	QC_DDR |= 1 << QC_DM;
}

void _dp600mV(){
	QC_DDR &= ~(1 << QC_DP);
}

void _dm600mV(){
	QC_DDR &= ~(1 << QC_DM);
}


void _dp3V3(){
	QC_PORT |= 1 << QC_DP;
	QC_DDR |= 1 << QC_DP;
}
void _dm3V3(){
	QC_PORT |= 1 << QC_DM;
	QC_DDR |= 1 << QC_DM;
}
