timChase98/SpeedOfLightContoller/(commit log)

2019-11-11 USBPD design review
    [ButtonBreakout.brd, ButtonBreakout.sch, SpeedOfLightController.brd, SpeedOfLightController.sch]
2019-11-12 Change to 100mm square board
    [SpeedOfLightController.brd, SpeedOfLightController.sch]
2019-11-13 Board Redone with notes from Ben
    [ButtonBreakout.brd, SpeedOfLightController.brd, SpeedOfLightController.sch]
2019-11-13 Updated rendered schematics
    [PnP_SpeedOfLightController_back.csv, PnP_SpeedOfLightController_front.csv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]
2019-11-25 commit before messing with the git settings
    [ButtonBreakout.csv, SpeedOfLightController.csv]
2019-11-25 Moving Stuff
    [ButtonBreakout.brd, ButtonBreakout.csv, ButtonBreakout.sch, SpeedOfLightController.brd, SpeedOfLightController.csv, SpeedOfLightController.sch]
2019-11-25 Done Moving Stuff?
    [ButtonBreakout.brd, ButtonBreakout.csv, ButtonBreakout.sch, SpeedOfLightController.brd, SpeedOfLightController.csv, SpeedOfLightController.sch]
2019-11-25 Moved Stuff?
    [ButtonBreakout.GBL, ButtonBreakout.GBO, ButtonBreakout.GBP, ButtonBreakout.GBS, ButtonBreakout.GKO, ButtonBreakout.GTL, ButtonBreakout.GTO, ButtonBreakout.GTP]
2019-11-27 Moved hardware into HW folder
    [ButtonBreakout.GBL, ButtonBreakout.GBO, ButtonBreakout.GBP, ButtonBreakout.GBS, ButtonBreakout.GKO, ButtonBreakout.GTL, ButtonBreakout.GTO, ButtonBreakout.GTP]
2019-11-27 reorginized button and LED code
2019-12-10 pushed modify button code
2019-12-11 fixed buttons and leds
    [buttons.c, main.c]
2019-12-22 fixed DC converter part number
    [BartendingButtons.csv, BartendingController.csv, ButtonBreakout.cfg, SpeedOfLightController.cfg, SpeedOfLightController_Bottom.csv]
